bjornvaktaren/ccd-kaf-cdip24/software/indigo/README.md

INDIGO driver
=============

Download the INDIGO drivers source. Copy ccd_mik to indigo_drivers in the INDIGO source code. Make the indigo drivers.
