bjornvaktaren/ccd-kaf-cdip24/ecad/kaf_board/power_requirements.ods

 | max current (mA) |  |  |  |  |  |  |  | max power (mW)
 | 3.3VD | 1.2V | 5V | 5V ADC | 12V | +15V | -15V |  | 3.3VD | 1.2V | 5V | 5V ADC | 12V | +15V | -15V
component | 3.3 | 1.2 | 5 | 5 | 12 | 15 | 15 |  | 3.3 | 1.2 | 5 | 5 | 12 | 15 | 15
FT2232H | 150 |  | 0 |  |  |  |  |  | 495 | 0 | 0 | 0 | 0 | 0 | 0
93LC56BT | 2 |  | 0 |  |  |  |  |  | 6.6 | 0 | 0 | 0 | 0 | 0 | 0
iCE40HX4K | 30.8 | 29.367 | 0 |  |  |  |  |  | 101.64 | 35.2404 | 0 | 0 | 0 | 0 | 0
MCP3004 | 1 |  | 0 |  |  |  |  |  | 3.3 | 0 | 0 | 0 | 0 | 0 | 0
AD9826 | 5 |  | 0 | 75 |  |  |  |  | 16.5 | 0 | 0 | 375 | 0 | 0 | 0
KAF-3200 |  |  | 0 |  |  | 10 | 10 |  | 0 | 0 | 0 | 0 | 0 | 150 | 150
MAX4649 |  |  | 0 |  |  | 0.1 | 0.1 |  | 0 | 0 | 0 | 0 | 0 | 1.5 | 1.5
TC4427 V1/V2 |  |  | 0 |  |  | 4.5 | 4.5 |  | 0 | 0 | 0 | 0 | 0 | 67.5 | 67.5
TC4427 R |  |  | 0 |  |  | 4.5 | 4.5 |  | 0 | 0 | 0 | 0 | 0 | 67.5 | 67.5
TC4428 H1/H2 |  |  | 0 |  |  | 4.5 | 4.5 |  | 0 | 0 | 0 | 0 | 0 | 67.5 | 67.5
LM224 1 |  |  | 0 |  |  | 6 | 6 |  | 0 | 0 | 0 | 0 | 0 | 90 | 90
LM224 2 |  |  | 0 |  |  | 6 | 6 |  | 0 | 0 | 0 | 0 | 0 | 90 | 90
LM224 3 |  |  | 0 |  |  | 6 | 6 |  | 0 | 0 | 0 | 0 | 0 | 90 | 90
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
