bjornvaktaren/ccd-kaf-cdip24/spice/bias_tee.asc

C1: cap; 33µ; V=10 Irms=15.2 Rser=0.00332739 Lser=0
L1: ind; 1000n; Ipk=0.4 Rser=0.648 Rpar=94.2 Cpar=0
R1: res; 1000k
R2: res; 1k
V1: voltage; -8.5
V2: voltage; PULSE(0 3.3 0 5n 5n 50n 100n 3200000)
Named nets: 0
.tran 1000ms
