bjornvaktaren/ccd-kaf-cdip24/ecad/kaf_board/kaf_board.kicad_pcb

## KiCad design ecad/kaf_board/kaf_board.kicad_pcb (2020-12-25)

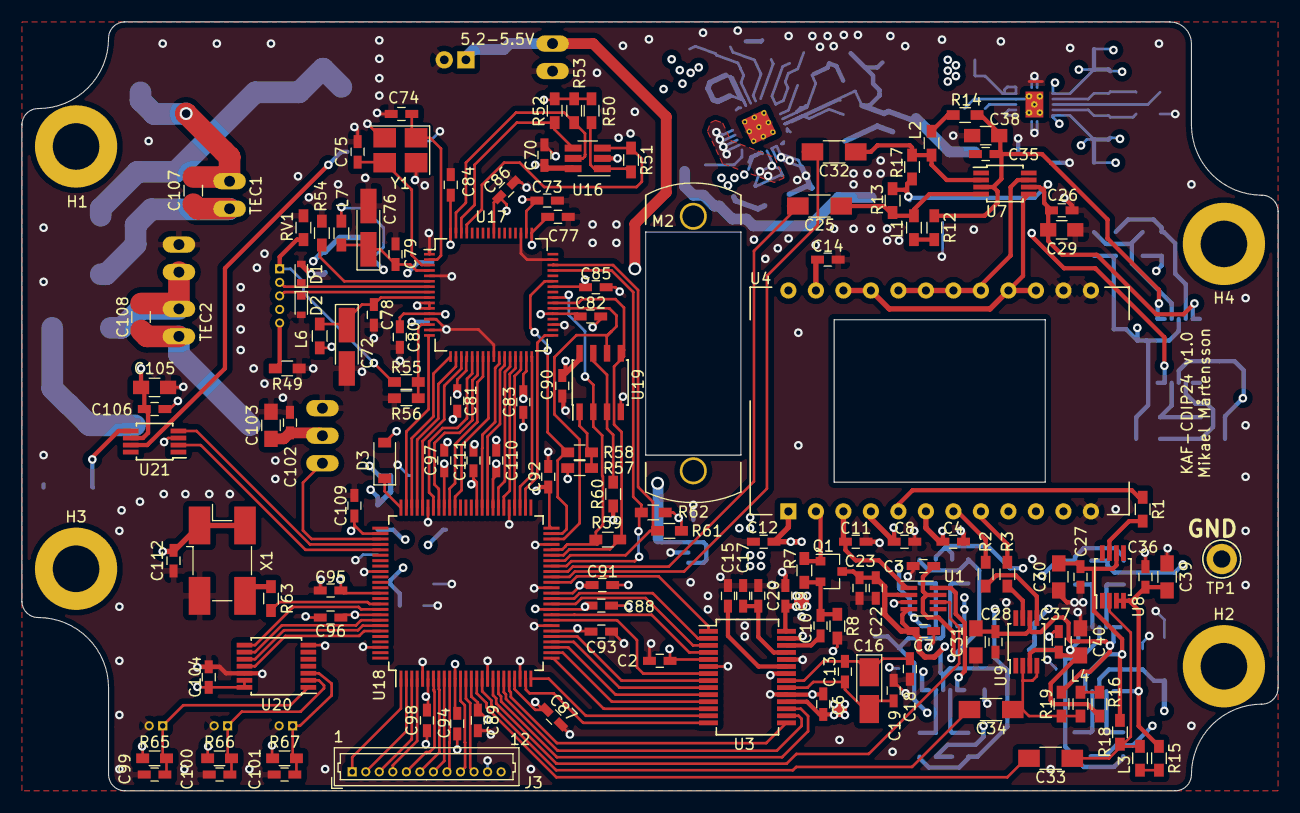
[picture p1: board kaf_board.kicad_pcb from above]

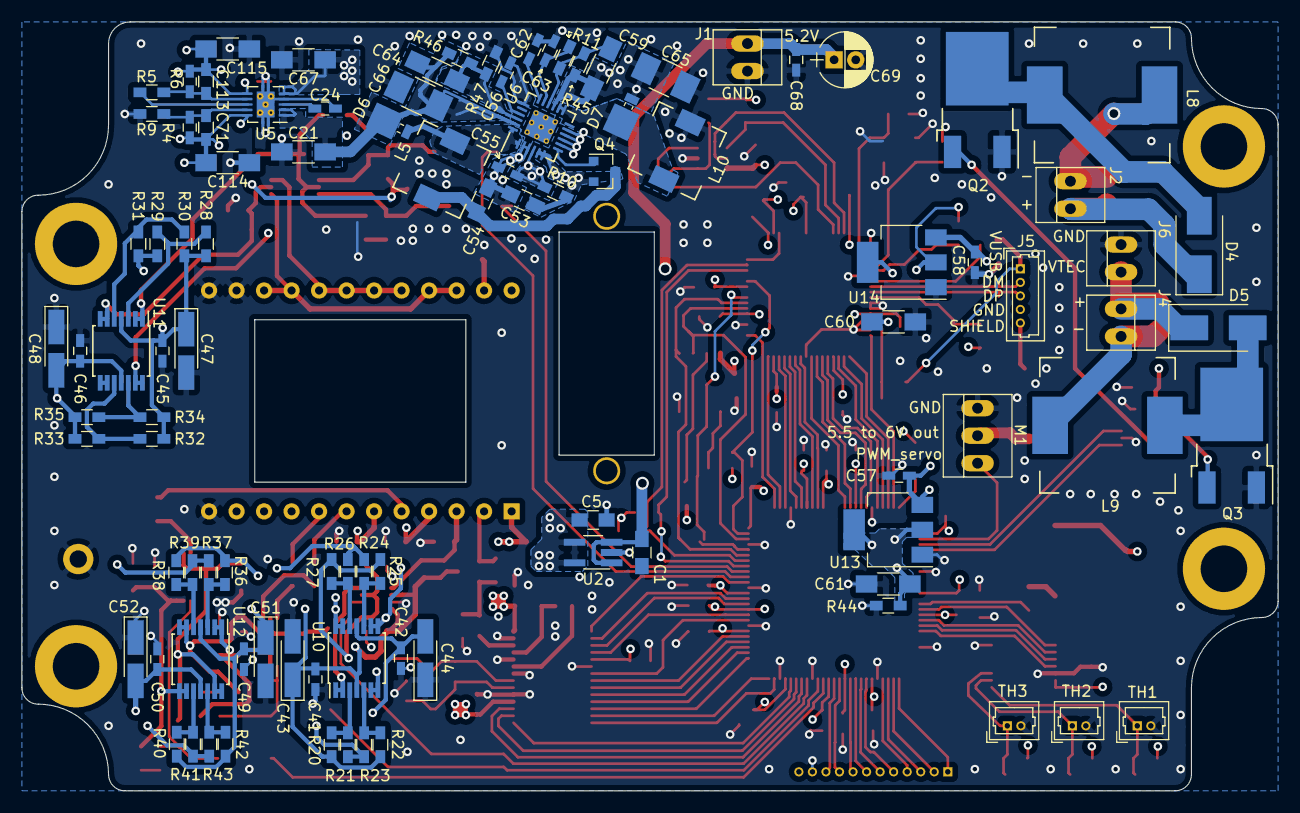
[picture p2: board kaf_board.kicad_pcb from below]

Board: 4 copper layers, 116.0 x 71.0 mm, 240 parts (99 on the bottom side), 159 nets.

Parts:
C1, C5: 2.2u X7R; C_0805_HandSoldering
C2, C3, C6, C7, C9, C10, C13, C15, C17, C18, C19, C23, C24, C26, C27, C28, C35, C36, C37, C41, C42, C45, C46, C49, C50, C55, C57, C58, C68, C70, C73, C78, C79, C80, C81, C82, C83, C84, C85, C86, C87, C88, C89, C90, C91, C92, C93, C94, C95, C96, C97, C98, C99, C100, C101, C102, C106, C109, C110, C111, C112: 0.1u; C_0603_HandSoldering
C4, C8, C11, C12, C14: 0; C_0603_HandSoldering
C16: 10u; CP_Tantalum_Case-R_EIA-2012-12_Hand
C20, C22, C104: 1u; C_0603_HandSoldering
C21, C60, C61, C67, C114, C115: 10u; C_1206_HandSoldering
C25, C32, C33, C34: 33u; C_1206_HandSoldering
C29, C30, C31, C38, C39, C40, C53, C54, C103, C105, C107, C108: 4.7u; C_0805_HandSoldering
C43, C44, C47, C48, C51, C52: 4.7u; CP_Tantalum_Case-A_EIA-3216-18_Hand
C56, C71, C113: 10n; C_0603_HandSoldering
C59: populate? No. (5.6p); C_1206_HandSoldering
C62: 4.7n; C_0603_HandSoldering
C63: 220n; C_0603_HandSoldering
C64: 6.8p; C_1206_HandSoldering
C65, C66: 22u; C_1210_HandSoldering
C69: 47u; CP_Radial_D5.0mm_P2.00mm
C72, C76: 4.7u tan; CP_Tantalum_Case-A_EIA-3216-18_Hand
C74, C75: 27p; C_0603_HandSoldering
C77: 3.3u; C_0603_HandSoldering
D1, D2: PGB101; D_0603
D3: 1N5819; D_SOD-123
D4, D5: VS-4EGU06-M3; D_SMB_Handsoldering
D6, D7: MBRM120; D_Powermite_AK
H1, H2, H3, H4: MountingHole; MountingHole_4.3mm_M4_ISO7380_Pad
J1: PWR; PINHEAD1-2
J2: TEC1; PINHEAD1-2
J3: Conn_01x12; Molex_PicoBlade_53047-1210_12x1.25mm_Straight
J4: TEC2; PINHEAD1-2
J5: USB; Molex_PicoBlade_53047-0510_05x1.25mm_Straight
J6: TECPWR; PINHEAD1-2
L1, L2, L3, L4: 1u; L_0603_HandSoldering
L5, L10: 4.7u; L_SMT_B82462G4
L6, L7: 600R/0.5A; L_0603_HandSoldering
L8, L9: 100u; L_Bourns_1210
M1: Motor_Servo; PINHEAD1-3
M2: Servo cut-out; HD-1440A
Q1: MMBT3904LT1G; SOT-23
Q2, Q3: NTD4804N; ONSemi_DPAK-3_5.97x6.35mm
Q4: Si2323DS; SOT-23
R1, R2, R3: 68; R_0603_HandSoldering
R4: 169k 0.1%; R_0603_HandSoldering
R5: 12k 0.1%; R_0603_HandSoldering
R6: 147k 0.1%; R_0603_HandSoldering
R7: 140; R_0603_HandSoldering
R8, R12, R14, R15, R16: 1k; R_0603_HandSoldering
R9: 15k 0.1%; R_0603_HandSoldering
R10: 100; R_0603_HandSoldering
R11: 104.8k; R_0603_HandSoldering
R13, R17, R18, R19, R49: NA; R_0603_HandSoldering
R20, R21, R22, R23, R24, R25, R26, R27, R28, R29, R30, R31, R32, R33, R34, R35, R36, R37, R38, R39, R40, R41, R42, R43: R; R_0603_HandSoldering
R44: 120; R_0603_HandSoldering
R45: 1.3M; R_0603_HandSoldering
R46: 975k; R_0603_HandSoldering
R47: 85.8k; R_0603_HandSoldering
R50, R52, R53, R56, R57, R60, R61, R65, R66, R67: 10k; R_0603_HandSoldering
R51: 2k; R_0603_HandSoldering
R54: 12k 1%; R_0603_HandSoldering
R55: 4.7k; R_0603_HandSoldering
R58, R63: 22; R_0603_HandSoldering
R59: NA(22); R_0603_HandSoldering
R62: 2.2k; R_0603_HandSoldering
RV1: V5.5MLA; R_0603_HandSoldering
TH1, TH2, TH3: 2000, beta 3500; Molex_PicoBlade_53047-0210_02x1.25mm_Straight
TP1: GND; Test_Point_Keystone_5005-5009_Compact
U1: MAX4649; SOT-23-8_Handsoldering
U2: ADP7118AUJZ; TSOT-23-5_HandSoldering
U3: AD9826; SSOP-28_5.3x10.2mm_Pitch0.65mm
U4: KAF-CDIP24; CDIP-24_20.2x34.5mm_P2.54mm
U5: TPS7A39; TI_WSON-10-1TP_3x3mm_P0.5mm_HandSolder
U6: TPS6513x; TI_WQFN-24-1EP_4x4mm_P0.5mm_HandSolder
U7, U8, U21: TC4427; MSOP-8_3x3mm_Pitch0.65mm
U9: TC4428; MSOP-8_3x3mm_Pitch0.65mm
U10, U11, U12: LM224; TSSOP-14_4.4x5mm_Pitch0.65mm
U13: LD1117S12CTR_SOT223; SOT-223-3_TabPin2
U14: LD1117S33CTR_SOT223; SOT-223-3_TabPin2
U16: 93LCxxBxxOT; SOT-23-6_Handsoldering
U17: FT2232HL; LQFP-64_10x10mm_Pitch0.5mm
U18: ICE40HX1K-VQ100; LQFP-100_14x14mm_Pitch0.5mm
U19: W25X20CL; SOIC-8_3.9x4.9mm_Pitch1.27mm
U20: MCP3004; TSSOP-14_4.4x5mm_Pitch0.65mm
X1: KC7050A-C3; Oscillator_SMD_EuroQuartz_XO91-4pin_7.0x5.0mm_HandSoldering
Y1: 12 MHz; Crystal_SMD_3225-4pin_3.2x2.5mm_HandSoldering

Connections:
+1V2: C61.1, C88.1, C94.1, C109.1, C111.1, R44.2, U13.2, U18.11, U18.35, U18.61, U18.77
+3V3: C2.2, C60.1, C70.1, C73.1, C81.1, C83.1, C85.1, C86.1, C87.1, C89.1, C90.1, C91.1, C92.1, C93.1, C95.1, C96.1, C97.1, C98.1, C104.1, C110.1, C112.1, D3.2, J3.12, L6.2, L7.2, R50.1, R52.1, R53.1, R57.2, R60.1, R61.1, R62.1, R65.1, R66.1, R67.1, U3.5, U14.2, U16.6, U17.20, U17.31, U17.42, U17.50, U17.56, U18.6, U18.14, U18.22, U18.31, U18.38, U18.50, U18.58, U18.67, U18.88, U18.92, U19.8, U20.13, U20.14, X1.1, X1.4
+6V: C1.2, C53.1, C57.1, C58.1, C68.1, C69.1, C102.1, C103.1, J1.1, M1.2, Q4.2, R10.2, U2.1, U2.3, U6.5, U6.6, U13.3, U14.3
+14.5V: C7.2, C22.2, C23.2, C41.2, C43.1, C45.2, C47.1, C49.2, C51.1, C71.2, C114.2, Q1.3, R4.1, R20.1, R22.1, R24.1, R26.1, R28.1, R30.1, R32.1, R34.1, R36.1, R38.1, R40.1, R42.1, U1.2, U1.4, U5.10, U10.4, U11.4, U12.4
-14.5V: C3.2, C42.2, C44.2, C46.2, C48.2, C50.2, C52.2, C113.1, C115.2, R6.2, R21.2, R23.2, R25.2, R27.2, R29.2, R31.2, R33.2, R35.2, R37.2, R39.2, R41.2, R43.2, U1.7, U5.6, U10.11, U11.11, U12.11
/ccd/AD_ADCLK: U3.3, U18.36
/ccd/AD_CDSCLK1: U3.1, U18.40
/ccd/AD_CDSCLK2: U3.2, U18.37
/ccd/AD_D0: U3.14, U18.24
/ccd/AD_D1: U3.13, U18.25
/ccd/AD_D2: U3.12, U18.26
/ccd/AD_D3: U3.11, U18.27
/ccd/AD_D4: U3.10, U18.28
/ccd/AD_D5: U3.9, U18.29
/ccd/AD_D6: U3.8, U18.30
/ccd/AD_D7: U3.7, U18.33
/ccd/AD_OEB: U3.4, U18.34
/ccd/AD_SCLK: U3.16, U18.20
/ccd/AD_SDATA: U3.15, U18.21
/ccd/AD_SLOAD: U3.17, U18.19
/ccd/AMP_OFF: U1.6, U18.18
/ccd/AVDD: C5.2, C6.2, C9.2, U2.4, U2.5, U3.18, U3.28
/ccd/H1: R2.2, U9.5
/ccd/H2: R3.2, U9.7
/ccd/H_3.3V: C34.2, U18.16
/ccd/R: R1.2, U8.7
/ccd/R_3.3V: C33.2, U18.15
/ccd/V1: U4.15, U4.16, U4.21, U4.22, U7.5
/ccd/V1_3.3V: C25.2, U18.42
/ccd/V2: U4.17, U4.18, U4.19, U4.20, U7.7
/ccd/VGUARD: C14.1, U4.23, U11.13, U11.14
/ccd/VOG: C12.1, U4.1, U10.6, U10.7
/ccd/VOUT_BUF: C10.1, Q1.2, R7.1, R8.1
/ccd/VRD: C8.1, U4.4, U10.8, U10.9
/ccd/VSS: C4.1, U4.6, U10.13, U10.14
/ccd/V_AMP: C11.1, U1.1, U4.3
/ccd/V_AMPL: U1.8, U10.1, U10.2
/ccd/V_HH: C28.2, C31.2, R19.1, U9.6, U12.6, U12.7
/ccd/V_HL: C37.2, C40.2, R16.1, U9.3, U12.1, U12.2
/ccd/V_RH: C27.2, C30.2, R18.1, U8.6, U12.13, U12.14
/ccd/V_RL: C36.2, C39.2, R15.1, U8.3, U8.4, U12.8, U12.9
/ccd/V_VH: C26.2, C29.2, R13.1, R17.1, U7.6, U11.6, U11.7
/ccd/V_VL: C35.2, C38.2, R12.1, R14.1, U7.3, U11.1, U11.2
/ccd/ccd_voltage_2/V3: U11.8, U11.9
/fpga/AUX1: J3.1, U18.1
/fpga/AUX2: J3.2, U18.2
/fpga/AUX3: J3.3, U18.3
/fpga/AUX4: J3.4, U18.4
/fpga/AUX5: J3.5, U18.7
/fpga/AUX6: J3.6, U18.8
/fpga/AUX7: J3.7, U18.9
/fpga/AUX8: J3.8, U18.10
/fpga/AUX9: J3.9, U18.12
/fpga/AUX10: J3.10, U18.13
/fpga/CLK: R63.1, U18.90
/fpga/FT_CLKOUT: U17.32, U18.53
/fpga/FT_D0: U17.16, U18.74
/fpga/FT_D1: U17.17, U18.73
/fpga/FT_D2: U17.18, U18.72
/fpga/FT_D3: U17.19, U18.71
/fpga/FT_D4: U17.21, U18.69
/fpga/FT_D5: U17.22, U18.68
/fpga/FT_D6: U17.23, U18.66
/fpga/FT_D7: U17.24, U18.65
/fpga/FT_OE#: U17.33, U18.52
/fpga/FT_RD#: U17.28, U18.57
/fpga/FT_RXF#: U17.26, U18.60
/fpga/FT_SIWUA: U17.30, U18.54
/fpga/FT_TXE#: U17.27, U18.59
/fpga/FT_WR#: U17.29, U18.56
/fpga/MCP_CLK: U18.95, U20.11
/fpga/MCP_CS_N: U18.91, U20.8
/fpga/MCP_DIN: U18.93, U20.9
/fpga/MCP_DOUT: U18.94, U20.10
/fpga/PWM_SERVO: M1.1, U18.78
/fpga/PWM_TEC1: U18.80, U21.2
/fpga/PWM_TEC2: U18.79, U21.4
/fpga/V1_3.3V: C32.2, U18.41
/fpga/VPP_2V5: D3.1, U18.75
/power/+15V: C21.2, C64.1, C66.1, D6.1, R46.2, U5.1, U5.2, U6.23
/power/-15V: C59.2, C65.1, C67.2, D7.2, R45.1, U5.5, U6.15
/thermo_and_mechanical/V_TEC: C105.1, C106.1, C107.1, C108.1, D4.1, D5.1, J2.1, J4.1, J6.1, U21.6
/usb-interface/DM: D1.1, J5.2, U17.7
/usb-interface/DP: D2.1, J5.3, U17.8
/usb-interface/FT_CDONE: R62.2, U17.45, U18.43
/usb-interface/FT_CRESET: R61.2, U17.46, U18.44
/usb-interface/FT_MISO: R59.1, U17.40, U18.46, U19.2
/usb-interface/FT_MOSI: R59.2, U17.39, U18.45, U19.5
/usb-interface/FT_SCK: U17.38, U18.48, U19.6
/usb-interface/FT_SS: R58.1, U17.43, U18.49
/usb-interface/VPHY: C76.1, C79.1, L7.1, U17.4
/usb-interface/VREG: C77.1, C80.1, C82.1, C84.1, U17.12, U17.37, U17.49, U17.64
/usb-interface/VUSB: J5.1, R55.2, RV1.2
GND: C1.1, C2.1, C3.1, C4.2, C5.1, C6.1, C7.1, C8.2, C9.1, C11.2, C12.2, C14.2, C15.2, C17.1, C18.2, C19.2, C20.1, C21.1, C22.1, C23.1, C24.1, C26.1, C27.1, C28.1, C29.1, C30.1, C31.1, C35.1, C36.1, C37.1, C38.1, C39.1, C40.1, C41.1, C42.1, C43.2, C44.1, C45.1, C46.1, C47.2, C48.1, C49.1, C50.1, C51.2, C52.1, C53.2, C54.2, C55.2, C56.2, C57.2, C58.2, C60.2, C61.2, C62.2, C63.2, C65.2, C66.2, C67.1, C68.2, C69.2, C70.2, C72.2, C73.2, C74.2, C75.1, C76.2, C77.2, C78.2, C79.2, C80.2, C81.2, C82.2, C83.2, C84.2, C85.2, C86.2, C87.2, C88.2, C89.2, C90.2, C91.2, C92.2, C93.2, C94.2, C95.2, C96.2, C97.2, C98.2, C99.2, C100.2, C101.2, C102.2, C103.2, C104.2, C105.2, C106.2, C109.2, C110.2, C111.2, C112.2, C114.1, C115.1, D1.2, D2.2, J1.2, J3.11, J5.4, J6.2, L10.1, M1.3, Q2.3, Q3.3, R8.2, R9.2, R44.1, R47.1, R49.1, R54.1, R56.2, RV1.1, TH1.2, TH2.2, TH3.2, TP1.1, U1.3, U2.2, U3.6, U3.19, U3.22, U3.24, U3.27, U4.12, U4.13, U4.14, U5.4, U5.11, U6.2, U6.3, U6.19, U6.25, U13.1, U14.1, U16.2, U17.1, U17.5, U17.10, U17.11, U17.13, U17.15, U17.25, U17.35, U17.47, U17.51, U18.5, U18.17, U18.23, U18.32, U18.39, U18.47, U18.55, U18.70, U18.84, U18.98, U19.4, U20.7, U20.12, U21.3, X1.2, Y1.2, Y1.4
GNDPWR: J5.5, R49.2
unnamed: C10.2, U3.26
unnamed: C13.1, C16.2, C19.1, U3.20
unnamed: C13.2, C16.1, C18.1, U3.21
unnamed: C15.1, U3.23
unnamed: C17.2, C20.2, U3.25
unnamed: C24.2, U5.3
unnamed: C25.1, L1.2, R13.2, U7.4
unnamed: C32.1, L2.2, R17.2, U7.2
unnamed: C33.1, L3.2, R18.2, U8.2
unnamed: C34.1, L4.2, R19.2, U9.2, U9.4
unnamed: C54.1, L5.2, Q4.3
unnamed: C55.1, R10.1, U6.4, U6.8, U6.9, U6.10, U6.11
unnamed: C56.1, U6.21
unnamed: C59.1, R11.1, R45.2, U6.16
unnamed: C62.1, U6.18
unnamed: C63.1, R11.2, U6.17
unnamed: C64.2, R46.1, R47.2, U6.22
unnamed: C71.1, R4.2, R9.1, U5.9
unnamed: C72.1, C78.1, L6.1, U17.9
unnamed: C74.1, U17.2, Y1.1
unnamed: C75.2, U17.3, Y1.3
unnamed: C99.1, R65.2, TH1.1, U20.1
unnamed: C100.1, R66.2, TH2.1, U20.2
unnamed: C101.1, R67.2, TH3.1, U20.3
unnamed: C107.2, J2.2, L8.1
unnamed: C108.2, J4.2, L9.1
unnamed: C113.2, R5.2, R6.1, U5.7
unnamed: D4.2, L8.2, Q2.2, Q2.4
unnamed: D5.2, L9.2, Q3.2, Q3.4
unnamed: D6.2, L5.1, U6.1, U6.24
unnamed: D7.1, L10.2, U6.13, U6.14
unnamed: L1.1, R12.2
unnamed: L2.1, R14.2
unnamed: L3.1, R15.2
unnamed: L4.1, R16.2
unnamed: Q1.1, R7.2, U4.2
unnamed: Q2.1, U21.7
unnamed: Q3.1, U21.5
unnamed: Q4.1, U6.7
unnamed: R1.1, U4.5
unnamed: R2.1, U4.7
unnamed: R3.1, U4.8
unnamed: R5.1, U5.8
unnamed: R20.2, R21.1, U10.3
unnamed: R22.2, R23.1, U10.5
unnamed: R24.2, R25.1, U10.10
unnamed: R26.2, R27.1, U10.12
unnamed: R28.2, R29.1, U11.3
unnamed: R30.2, R31.1, U11.5
unnamed: R32.2, R33.1, U11.10
unnamed: R34.2, R35.1, U11.12
unnamed: R36.2, R37.1, U12.3
unnamed: R38.2, R39.1, U12.5
unnamed: R40.2, R41.1, U12.10
unnamed: R42.2, R43.1, U12.12
unnamed: R50.2, R51.2, U16.1
unnamed: R51.1, U16.3, U17.61
unnamed: R52.2, U16.4, U17.62
unnamed: R53.2, U16.5, U17.63
unnamed: R54.2, U17.6
unnamed: R55.1, R56.1, U17.14
unnamed: R57.1, R58.2, U19.1
unnamed: R60.2, U19.3, U19.7
unnamed: R63.2, X1.3
