bjornvaktaren/ccd-kaf-cdip24/firmware/controller.v

`default_nettype none

// `include "ram.v"
// `include "spi_slave.v"
`include "mcp3008_interface.v"
`include "sync_ft245.v"
`include "ccd_readout.v"
`include "fifo.v"

module controller
  (clk,         // clock
   ft_bus,      // ft232h data bus
   ft_rxf_n,    // ft232h read fifo (active low)
   ft_txe_n,    // ft232h transmit enable (active low)
   ft_rd_n,     // ft232h read data (active low)
   ft_wr_n,     // ft232h write (active low)
   ft_siwu_n,   // ft232h send immediate / wake up (active low)
   ft_clkout,   // ft232h clock
   ft_oe_n,     // ft232h output enable (active low)
   mcp_dclk,    // mcp3008 data clock
   mcp_dout,    // mcp3008 data out
   mcp_din,     // mcp3008 data in
   mcp_cs_n,    // mcp3008 active low chip select
   ad_cdsclk1,  // AD9826 correlated double-sampling clock 1
   ad_cdsclk2,  // AD9826 correlated double-sampling clock 1
   ad_adclk,    // AD9826 data clock
   ad_oeb_n,    // AD9826 output enable (active low)
   kaf_r,       // CCD reset clock
   kaf_h1,      // CCD H1 clock
   kaf_h2,      // CCD H2 clock
   kaf_v1,      // CCD V1 clock
   kaf_v2,      // CCD V2 clock
   kaf_amp,     // CCD amplifier on/off
   ad_data,     // Data output form the AD9826
   pwm_shutter, // PWM output for controlling the shutter servo
   pwm_peltier  // PWM output for controlling the peltier cooling
   );
   
   input        clk;
   inout [7:0]  ft_bus;
   input 	ft_rxf_n;
   input 	ft_txe_n;
   input        ft_clkout;
   output wire  ft_rd_n;
   output wire  ft_wr_n;
   output wire  ft_siwu_n;
   output wire 	ft_oe_n;
   input 	mcp_dout;
   output wire 	mcp_dclk;
   output wire  mcp_din;
   output wire 	mcp_cs_n;
   output wire  ad_cdsclk1;
   output wire 	ad_cdsclk2;
   output wire 	ad_adclk;
   output wire 	ad_oeb_n;
   output wire  kaf_r;
   output wire 	kaf_h1;
   output wire 	kaf_h2;
   output wire 	kaf_v1;
   output wire 	kaf_v2;
   output wire 	kaf_amp;
   input [7:0]  ad_data;
   output wire 	pwm_shutter;
   output wire 	pwm_peltier;

   // Gray coded states
   // 
   localparam state_idle             = 4'b0000; 
   // get command from FT245 interface
   localparam state_get_cmd          = 4'b0001;
   // evaluate the recieved command
   localparam state_eval_cmd         = 4'b0011;
   // send msb of ft_output_reg
   localparam state_ft_send_msb      = 4'b0010;
   // wait for handshake
   localparam state_ft_send_msb_wait = 4'b0110;
   // send lsb of ft_output_reg
   localparam state_ft_send_lsb      = 4'b0111;
   // wait for handshake
   localparam state_ft_send_lsb_wait = 4'b0101;
   // move mcp3008 output to ft_output_reg
   localparam state_move_mcp         = 4'b0100;
   // read out the ccd
   localparam state_toggle_ccd       = 4'b1100;
   // read out the ccd
   localparam state_ccd_wait_busy    = 4'b1101;

   // Shutter states
   localparam shutter_state_open   = 1'b0; // open shutter
   localparam shutter_state_closed = 1'b1; // close shutter

   // include header file with localparams needed across modules or for sim
   `include "controller.vh"

   // Clock divider
   
   reg [15:0] 	clk_div = 0;

   always @(posedge clk) begin
      clk_div <= clk_div + 1;
   end

      
   // Synchronous FT245 Interface
   
   reg        data_to_ft_avail;
   reg  [7:0] data_to_ft;
   wire       data_from_ft_avail;
   wire [7:0] data_from_ft;

   sync_ft245 sync_ft245 
     (
      .ft_bus(ft_bus),
      .ft_rxf_n(ft_rxf_n),
      .ft_txe_n(ft_txe_n),
      .ft_rd_n(ft_rd_n),
      .ft_wr_n(ft_wr_n),
      .ft_siwu_n(ft_siwu_n),
      .ft_clkout(ft_clkout),
      .ft_oe_n(ft_oe_n),
      .data_to_ft(data_to_ft),
      .data_to_ft_avail(data_to_ft_avail),
      .data_from_ft(data_from_ft),
      .data_from_ft_avail(data_from_ft_avail)
      );


   // MCP3008 ADC interface

   reg 	      mcp_sample = 0;
   wire       mcp_busy;
   wire [9:0] mcp_data;
   wire       mcp_dclk_internal;
`ifdef SYNTHESIS
   // 100 MHz / 2^(6+1) = 0.78 MHz
   assign mcp_dclk_internal = clk_div[6];
`else
   // Makes is easier to see in simulation
   assign mcp_dclk_internal = clk_div[6];
`endif
   // Only output the clock if needed
   assign mcp_dclk = (mcp_cs_n == 1'b0) ? mcp_dclk_internal : 1'b1;

   mcp3008_interface mcp3008
     (
      mcp_sample,
      mcp_dclk_internal, // mcp3008 data clock, internal to the FPGA
      mcp_dout,          // mcp3008 data out
      mcp_din,           // mcp3008 data in
      mcp_cs_n,          // mcp3008 active low chip select
      mcp_busy,
      mcp_data
      );


   // Readout module for the CCD and CCD signal processor
   
   `include "ccd_readout.vh"

   wire      ccd_busy;
   reg       ccd_toggle;
   reg [1:0] ccd_mode = ccd_mode_readout_1x1;
   
   ccd_readout ccd
     (
      .ad_cdsclk1(ad_cdsclk1),
      .ad_cdsclk2(ad_cdsclk2),
      .ad_adclk(ad_adclk),
      .ad_oeb_n(ad_oeb_n),
      .kaf_r(kaf_r),
      .kaf_h1(kaf_h1),
      .kaf_h2(kaf_h2),
      .kaf_v1(kaf_v1),
      .kaf_v2(kaf_v2),
      .kaf_amp(kaf_amp),
      .counter(clk_div),
      .busy(ccd_busy),
      .toggle(ccd_toggle),
      .mode(ccd_mode)
      );


   // FIFO for ccd readout
   wire      fifo_write_clk = clk_div[ccd_counter_clk_bit];

   fifo #(8, 8) fifo
     (
      .rdata(),
      .wfull(),
      .rempty(),
      .wdata(ad_data),
      .winc(),
      .wclk(fifo_write_clk),
      .wrst_n(),
      .rinc(),
      .rclk(ft_clkout),
      .rrst_n()
      );
   

   // Shutter PWM
   
   reg [7:0] pwm_shutter_duty_cycle = shutter_closed_duty_cycle;
   localparam shutter_closed_duty_cycle = 8'h10;
   localparam shutter_open_duty_cycle = 8'h20;
  
   assign pwm_shutter = clk_div[7:0] <= pwm_shutter_duty_cycle ? 1 : 0;


   // State-machine
   
   reg [3:0]   state = state_idle;
   reg 	       shutter_state = shutter_state_closed;
   reg [15:0]  ft_output_reg;
   reg [7:0]   command;
   
   // state logic
   always @(posedge clk) begin

      case (state)
	
   	state_idle:
	  // wait for ft245 interface to tell the fpga what to do
	  if (ft_rxf_n == 1'b0) 
	    state <= state_get_cmd;
	
	state_get_cmd:
	  // wait for the sync_ft245 module to have recieved data
	  if (data_from_ft_avail == 1'b1)
	    state <= state_eval_cmd;

	state_eval_cmd: begin
	   // Take different actions. Go back to idle if the command is invalid
	   state <= state_idle;
	   if (data_from_ft == cmd_get_mcp)
	     state <= state_move_mcp;
	   if (data_from_ft == cmd_read_ccd)
	     state <= state_toggle_ccd;
	   if (data_from_ft == cmd_shutter_close)
	     shutter_state <= shutter_state_closed;
	   if (data_from_ft == cmd_shutter_open)
	     shutter_state <= shutter_state_open;
	end

	// state_sample_mcp:
	//   if (mcp_busy == 1'b1)
	//     state <= state_mcp_wait;
	
	// state_mcp_wait:
	//   if (mcp_busy == 1'b0)
	//     state <= state_mcp_to_ft_bus;
	
	state_toggle_ccd:
	  if (ccd_busy == 1'b0)
	    state <= state_ccd_wait_busy;
	
	state_ccd_wait_busy:
	  // while there is data in the fifo
	  if (ccd_busy == 1'b1)
	    state <= state_ft_send_lsb;

	state_move_mcp:
	  if (ft_txe_n == 1'b0)
	    state <= state_ft_send_msb;

	state_ft_send_msb:
	  if (ft_wr_n == 1'b0)
	    state <= state_ft_send_msb_wait;
	
	state_ft_send_msb_wait:
	  if (ft_wr_n == 1'b1)
	    state <= state_ft_send_lsb;

	state_ft_send_lsb:
	  if (ft_wr_n == 1'b0)
	    state <= state_ft_send_lsb_wait;
	
	state_ft_send_lsb_wait:
	  // should go back to state_ccd_to_ft_bus if streaming
	  if (ft_wr_n == 1'b1)
	    state <= state_idle; 

	// state_shutter_open:
	//     state <= state_idle; 

	// state_shutter_close:
	//     state <= state_idle; 
	
   	default: state <= state_idle;
	
      endcase // case (state)
      
   end // always @ (posedge clk)
   

   // state task logic
   always @* begin

      data_to_ft_avail   = 1'b0;
      data_to_ft         = 8'b0;
      ccd_toggle         = 0;
      ft_output_reg      = 16'b0;
	
      if(state == state_idle) begin
      end
      if(state == state_get_cmd) begin
      end
      if(state == state_eval_cmd) begin
      end
      if(state == state_ft_send_msb) begin
	 data_to_ft       = ft_output_reg[15:8];
	 data_to_ft_avail = 1'b1;
      end
      if(state == state_ft_send_msb_wait) begin
	 data_to_ft       = ft_output_reg[15:8];
	 data_to_ft_avail = 1'b0;
      end
      if(state == state_ft_send_lsb) begin
	 data_to_ft       = ft_output_reg[7:0];
	 data_to_ft_avail = 1'b1;
      end
      if(state == state_ft_send_lsb_wait) begin
	 data_to_ft       = ft_output_reg[7:0];
	 data_to_ft_avail = 1'b0;
      end
      if(state == state_toggle_ccd) begin
	 ccd_toggle = 1'b1;
      end
      if(state == state_ccd_wait_busy) begin
	 ccd_toggle = 1'b1;
      end
      if(state == state_move_mcp) begin
	 ft_output_reg[9:0]   = mcp_data;
	 ft_output_reg[15:10] = 6'b0;
      end
      
      // shutter states
      if(shutter_state == shutter_state_open) begin
	 pwm_shutter_duty_cycle = shutter_open_duty_cycle;
      end
      if(shutter_state == shutter_state_closed) begin
	 pwm_shutter_duty_cycle = shutter_closed_duty_cycle;
      end
   end // always @*


   // continuously sample the temperture sensors connected to the mcp
   wire mcp_sample_clk = clk_div[11]; // should be every second or so.
   
   always @(posedge mcp_sample_clk) begin
      // If the ADC is done converting, shift out the 16 bits
      mcp_sample <= ~mcp_sample;
   end


   
endmodule // controller
