bjornvaktaren/ccd-kaf-cdip24/firmware/testbench/ad9826_config_state_filter.txt

# ad9826_config module state filter for GTKWave
00000 idle
00001 rw
00011 a2
00010 a1
00110 a0
00111 dc1
00101 dc2
00100 dc3
01100 rd8
01101 rd7
01111 rd6
01110 rd5
01010 rd4
01011 rd3
01001 rd2
01000 rd1
11000 rd0
11001 wait_fifo
11011 wd8
11010 wd7
11110 wd6
11111 wd5
11101 wd4
11100 wd3
10100 wd2
10101 wd1
10111 wd0
