bjornvaktaren/ccd-kaf-cdip24/software/src/Camera.cpp

#include <Camera.hpp>

Camera::Camera(Ft245Interface& ft245)
    : m_verbosity{Verbosity::info},
      m_coolerOn{false},
      ft245_{ft245},
      m_ad{},
      m_thermistors{{fpga::thermistor_id::ambient,
                     Thermistor(2000.0, 3500.0, 3.3, 10000, 1023.0)},
                    {fpga::thermistor_id::ccd,
                     Thermistor(2000.0, 3500.0, 3.3, 10000, 1023.0)},
                    {fpga::thermistor_id::tec,
                     Thermistor(2000.0, 3500.0, 3.3, 10000, 1023.0)}},
      m_ccdTargetTemperature{20.0},
      m_pid{0.0, 255.0, -42.0, -0.3,
            0.0},  // PID regulator: min, max, kp, ki, kd
      m_pidOutPercent{-1.0},
      m_imageData{},
      m_rawPixelData{} {
   m_imageData.resize(this->getWidth() * this->getHeight(), 0);
   m_rawPixelData.resize(this->getWidth() * this->getHeight() * 3, 0);
}

void Camera::connect() {
   int status = ft245_.Open();
   if (status != 0) {
      throw std::runtime_error("Unable to connect to camera");
   }
   if (!ft245_.WriteByte(fpga::command::reset)) {
      throw std::runtime_error("Unable to reset camera");
   }

   // Configure the AD9826
   ft245_.Write({
       fpga::command::rw_adconf, fpga::ad9826::cmd::write_config,
       0b11011000  // 4 V input, internal Vref, 1 Ch mode, CDS, 4V clamp
   });
   // Read back the result, same number of bytes. Discard with the
   // result.
   auto data{ft245_.Read(3)};
   this->setGain(35);  // default gain
}

// void Camera::disconnect() { ft245_.close(); }

// bool Camera::setGain(const unsigned char gain) {
//    if (gain > 63) {
//       std::cout << "Gain can't be larger than 63. Ignoring.\n";
//       return false;
//    }

//    // Configure the AD9826
//    const size_t nBytes = 3;
//    const unsigned char writeBuffer[nBytes] = {
//        fpga::command::rw_adconf,
//        fpga::ad9826::cmd::write_gain,
//        gain,
//    };
//    bool ok = ft245_.write(writeBuffer, nBytes);
//    // Read back the result, same number of bytes. Discard with the result.
//    unsigned char buffer[nBytes] = {0};
//    int readBytes = ft245_.read(buffer, nBytes);

//    return ok;
// }

// bool Camera::setOffset(const unsigned char offset, const bool negative) {
//    // If negative, the LSB of the command is set to 1.
//    unsigned char write_cmd = fpga::ad9826::cmd::write_offset;
//    if (negative) write_cmd |= 0b00000001;
//    std::cout << std::bitset<8>(write_cmd) << ' ' << std::bitset<8>(offset)
//              << '\n';

//    // Configure the AD9826
//    const size_t nBytes = 3;
//    const unsigned char writeBuffer[nBytes] = {
//        fpga::command::rw_adconf,
//        write_cmd,
//        offset,
//    };
//    bool ok = ft245_.write(writeBuffer, nBytes);
//    // Read back the result, same number of bytes. Discard the result.
//    unsigned char buffer[nBytes] = {0};
//    int readBytes = ft245_.read(buffer, nBytes);

//    return ok;
// }

// void Camera::startExposure(const bool openShutter) {
//    std::cout << "Flushing\n";
//    this->flushSensor();
//    std::this_thread::sleep_for(std::chrono::seconds(2));
//    if (openShutter) {
//       std::cout << "Open shutter\n";
//       this->openShutter();
//    }
// }

// void Camera::stopExposure(const bool closeShutter) {
//    if (closeShutter) {
//       std::cout << "Close shutter\n";
//       this->closeShutter();
//    }
//    const size_t nBytesWrite = 4;
//    const unsigned char writeBuffer[nBytesWrite] = {
//        fpga::command::set_register, fpga::reg_addr::ccd_readout_mode,
//        fpga::ccd_readout_mode::bin1x1, fpga::command::toggle_read_ccd};
//    std::cout << "Initiating Readout\n";
//    bool ok = ft245_.write(writeBuffer, nBytesWrite);

//    // Get the image data
//    const size_t chunksize = 16384;  // Max buffer size in libftdi
//    size_t totalBytesRead = 0;
//    const size_t bytesToRead = this->getWidth() * this->getHeight() * 3;
//    int nTimesStuck = 0;
//    while (totalBytesRead < bytesToRead && nTimesStuck < 20) {
//       size_t bytesLeft = bytesToRead - totalBytesRead;
//       size_t chunk = bytesLeft < chunksize ? bytesLeft : chunksize;
//       // std::cout << "Trying to read " << chunk << " bytes\n";
//       unsigned char buffer[chunk] = {255};
//       size_t bytesRead = ft245_.read(buffer, chunk);
//       // Just dump it to a vector and process it later
//       for (size_t i = 0; i < bytesRead; ++i) {
//          m_rawPixelData[i + totalBytesRead] = buffer[i];
//       }
//       if (bytesRead <= 0)
//          ++nTimesStuck;
//       else
//          nTimesStuck = 0;
//       totalBytesRead += bytesRead > 0 ? bytesRead : 0;
//    }
//    // Decode raw data to
//    for (int i = 0; i < totalBytesRead / 3; ++i) {
//       auto packet =
//           this->decodePacket(m_rawPixelData[3 * i], m_rawPixelData[3 * i +
//           1],
//                              m_rawPixelData[3 * i + 2]);
//       if (packet.topic == fpga::DataTopic::pixel) {
//          m_imageData[i] = packet.data;
//       } else {
//          std::cout << "DEBUG: Expected pixel, but got someting else\n";
//       }
//    }
// }

// void Camera::flushSensor() {
//    // Configure
//    const size_t nBytes = 4;
//    const unsigned char writeBuffer[nBytes] = {
//        fpga::command::set_register, fpga::reg_addr::ccd_readout_mode,
//        fpga::ccd_readout_mode::flush, fpga::command::toggle_read_ccd};
//    bool ok = ft245_.write(writeBuffer, nBytes);
// }

// fpga::DataPacket Camera::decodePacket(const unsigned char byte1,
//                                       const unsigned char byte2,
//                                       const unsigned char byte3) {
//    if (m_verbosity == Verbosity::debug) {
//       std::cout << "DEBUG: "
//                 << " Got bytes " << std::bitset<8>(byte1) << '_'
//                 << std::bitset<8>(byte2) << '_' << std::bitset<8>(byte3);
//    }
//    fpga::DataPacket dataPacket;
//    if (byte1 == fpga::data_topic::mcp) {
//       dataPacket.topic = fpga::DataTopic::mcp;
//       if (m_verbosity == Verbosity::debug) {
//          std::cout << ": "
//                    << " topic 'mcp'";
//       }
//    } else if (byte1 == fpga::data_topic::adconf) {
//       dataPacket.topic = fpga::DataTopic::adconf;
//       if (m_verbosity == Verbosity::debug) {
//          std::cout << ": "
//                    << " topic 'adconf'";
//       }
//    } else if (byte1 == fpga::data_topic::pixel) {
//       dataPacket.topic = fpga::DataTopic::pixel;
//       if (m_verbosity == Verbosity::debug) {
//          std::cout << ": "
//                    << " topic 'pixel'";
//       }
//    } else {
//       std::cout << "Error: "
//                 << " Got unknown topic byte: " << std::bitset<8>(byte1) <<
//                 '\n';
//    }

//    dataPacket.data =
//        (static_cast<uint16_t>(byte2) << 8) | static_cast<uint16_t>(byte3);
//    if (m_verbosity == Verbosity::debug) {
//       std::cout << ", data " << std::bitset<16>(dataPacket.data) << '\n';
//    }
//    return dataPacket;
// }

// void Camera::decodeTemperatures(const fpga::DataPacket packet) {
//    try {
//       m_thermistors.at(packet.data & fpga::thermistor_id::bitmask)
//           .setMeasurement(packet.data & ~fpga::thermistor_id::bitmask);
//    } catch (const std::out_of_range& oor) {
//       std::cerr << "ERROR: Unable to decode thermistor ID. Exception: "
//                 << oor.what() << '\n';
//    }
// }

// void Camera::decodeAD9826ConfigPacket(const fpga::DataPacket packet) {
//    const uint16_t address = packet.data & fpga::ad9826::reg::addr_mask;
//    const uint16_t data = packet.data & fpga::ad9826::reg::data_mask;
//    const std::bitset<16> bits(data);

//    if (address == fpga::ad9826::reg::config) {
//       m_ad.inputRange = bits.test(7) ? "4V" : "2V";
//       m_ad.internalVRef = bits.test(6);
//       m_ad.threeChMode = bits.test(5);
//       m_ad.cdsMode = bits.test(4);
//       m_ad.inputClamp = bits.test(3) ? "4V" : "3V";
//       m_ad.powerDown = bits.test(2);
//    } else if (address == fpga::ad9826::reg::muxconfig) {
//       m_ad.muxOrder = bits.test(7) ? "RGB" : "BGR";
//       m_ad.redSelect = bits.test(6);
//       m_ad.greenSelect = bits.test(5);
//       m_ad.blueSelect = bits.test(4);
//    } else if (address == fpga::ad9826::reg::gain) {
//       m_ad.gainInteger = data;
//       m_ad.gainVolt =
//           6.0 / (1.0 + 5.0 * (63 - static_cast<double>(data)) / 63.0);
//    } else if (address == fpga::ad9826::reg::offset) {
//       m_ad.offsetInteger = data;
//       m_ad.offsetMilliVolt =
//           1.17647058823529411765 *
//           static_cast<double>(data & 0x00FF);  // Just the 8 LSBs
//       if (bits.test(8)) m_ad.offsetMilliVolt = -1.0 * m_ad.offsetMilliVolt;
//    } else if (m_verbosity == Verbosity::debug) {
//       std::cout << "Unknown AD9826 register\n";
//    }
// }

// bool Camera::getAD9826Config() {
//    //
//    const size_t nBytes = 12;
//    const unsigned char writeBuffer[nBytes] = {
//        fpga::command::rw_adconf, fpga::ad9826::cmd::read_config,     0x00,
//        fpga::command::rw_adconf, fpga::ad9826::cmd::read_mux_config, 0x00,
//        fpga::command::rw_adconf, fpga::ad9826::cmd::read_gain,       0x00,
//        fpga::command::rw_adconf, fpga::ad9826::cmd::read_offset,     0x00};
//    ft245_.write(writeBuffer, nBytes);

//    // Read back the result, same number of bytes
//    unsigned char buffer[nBytes] = {0};
//    int readBytes = ft245_.read(buffer, nBytes);

//    // Decode the recieved data
//    for (int i = 0; i < 4; ++i) {
//       auto pkt = this->decodePacket(buffer[i * 3], buffer[i * 3 + 1],
//                                     buffer[i * 3 + 2]);
//       this->decodeAD9826ConfigPacket(pkt);
//    }

//    m_ad.print();

//    return true;
// }

// bool Camera::sampleTemperatures() {
//    ft245_.writeByte(fpga::command::toggle_mcp);
//    // The FTDI latency timer is dominating the delay, so delay is not needed.

//    // Store timepoint to be used to update PID regulator
//    auto now = std::chrono::steady_clock::now();

//    // Read back the result
//    const size_t nBytes = 9;
//    unsigned char buffer[nBytes] = {0};
//    int readBytes = ft245_.read(buffer, nBytes);

//    if (m_verbosity == Verbosity::debug) {
//       std::cout << "DEBUG: Received ";
//       for (int i = 0; i < nBytes; ++i) {
//          std::cout << ' ' << std::bitset<8>(buffer[i]);
//       }
//       std::cout << '\n';
//    }

//    // Decode the recieved packets to temperature values
//    for (int i = 0; i < 3; ++i) {
//       auto pkt = this->decodePacket(buffer[i * 3], buffer[i * 3 + 1],
//                                     buffer[i * 3 + 2]);
//       if (pkt.topic == fpga::DataTopic::mcp) {
//          this->decodeTemperatures(pkt);
//       } else if (m_verbosity == Verbosity::debug) {
//          std::string topic = "unknown";
//          if (pkt.topic == fpga::DataTopic::adconf)
//             topic = "adconf";
//          else if (pkt.topic == fpga::DataTopic::pixel)
//             topic = "pixel";
//          std::cout << "DEBUG: "
//                    << " Expected topic 'mcp', got topic '" << topic << "'\n";
//       }
//    }

//    // Update PID regulator if cooling is on
//    if (m_coolerOn) {
//       double pidOut = m_pid.calculate(
//           now,
//           this->m_thermistors.at(fpga::thermistor_id::ccd).getCelsius());
//       m_pidOutPercent =
//           pidOut / (m_pid.getMaximum() - m_pid.getMinimum()) * 100.0;
//       unsigned char pwm1 = static_cast<unsigned char>(pidOut);
//       // The cold-side Peltier element should not cool as much
//       unsigned char pwm2 = static_cast<unsigned char>(pidOut * 0.8);
//       this->setPeltierPWM(1, pwm1);
//       this->setPeltierPWM(2, pwm2);
//    }

//    return readBytes == nBytes;
// }

// double Camera::getTemperature(const uint16_t thermistor) {
//    return m_thermistors.at(thermistor).getCelsius();
// }

// bool Camera::openShutter() {
//    return ft245_.writeByte(fpga::command::open_shutter) == 1;
// }

// bool Camera::closeShutter() {
//    return ft245_.writeByte(fpga::command::close_shutter) == 1;
// }

// bool Camera::setPeltierPWM(const int peltier, const unsigned char pwmVal) {
//    unsigned char writeBuffer[3];
//    writeBuffer[0] = fpga::command::set_register;

//    if (peltier == 1) {
//       writeBuffer[1] = fpga::reg_addr::tec1_duty;
//    } else if (peltier == 2) {
//       writeBuffer[1] = fpga::reg_addr::tec2_duty;
//    } else {
//       std::cerr << "Unsupported peltier '" << peltier << "'\n";
//       return false;
//    }
//    writeBuffer[2] = pwmVal;

//    // Just write: we are not expecting anything back from the FPGA.
//    return ft245_.write(writeBuffer, 3);
// }

// bool Camera::setCCDReadoutMode(const unsigned char mode) {
//    unsigned char writeBuffer[3];
//    writeBuffer[0] = fpga::command::set_register;
//    writeBuffer[1] = fpga::reg_addr::ccd_readout_mode;
//    writeBuffer[2] = mode;

//    return ft245_.write(writeBuffer, 3);
// }

// void Camera::setVerbosity(Verbosity v) {
//    m_verbosity = v;
//    m_pid.setVerbosity(v);
// }

// void Camera::setCoolerOn(const bool on) {
//    // Turn off cooling by setting the PWM outputs to 0
//    if (!on) {
//       this->setPeltierPWM(1, 0);
//       this->setPeltierPWM(2, 0);
//    }
//    m_coolerOn = on;
// }

// void Camera::setTemperature(double celsius) { m_pid.setTarget(celsius); }

// void Camera::reset() {
//    if (!ft245_.writeByte(fpga::command::reset)) {
//       throw std::runtime_error("Unable to reset camera");
//    }
// }

// std::vector<uint16_t> Camera::getActiveImageData() {
//    // Discards all invalid pixels at the sensor edges
//    std::vector<uint16_t> activeImageData;
//    for (int y = 0; y < this->getActiveHeight(); ++y) {
//       for (int x = 0; x < this->getActiveWidth(); ++x) {
//          activeImageData.push_back(
//              m_imageData[x + this->getInvalidLeft() + y * this->getWidth()]);
//       }
//    }
//    std::cout << m_imageData.size() << '\n';
//    return activeImageData;
// }
