bjornvaktaren/ccd-kaf-cdip24/software/include/Fpga.hpp

#pragma once

#include <stdint.h>

namespace fpga {

namespace command {
static constexpr unsigned char none = 0b00000000;
static constexpr unsigned char toggle_mcp = 0b00000001;
static constexpr unsigned char toggle_read_ccd = 0b00000010;
static constexpr unsigned char open_shutter = 0b00000100;
static constexpr unsigned char close_shutter = 0b00001000;
static constexpr unsigned char rw_adconf = 0b00010000;
static constexpr unsigned char set_register = 0b00100000;
static constexpr unsigned char reset = 0b11111111;
}  // namespace command

// Named addresses of the FPGA internal register
namespace reg_addr {
static constexpr unsigned char tec1_duty = 0;
static constexpr unsigned char tec2_duty = 1;
static constexpr unsigned char ccd_readout_mode = 2;
}  // namespace reg_addr

// Supported read-out modes
namespace ccd_readout_mode {
static constexpr unsigned char flush = 0b00000000;
static constexpr unsigned char bin1x1 = 0b00000001;
static constexpr unsigned char bin2x2 = 0b00000010;
}  // namespace ccd_readout_mode

// Named commands to read/write from/to the AD9826 configuration register
namespace ad9826 {
namespace cmd {
static constexpr unsigned char write_config = 0b00000000;
static constexpr unsigned char read_config = 0b10000000;
static constexpr unsigned char write_mux_config = 0b00010000;
static constexpr unsigned char read_mux_config = 0b10010000;
// Red PGA gain register. We are not using the others.
static constexpr unsigned char write_gain = 0b00100000;
static constexpr unsigned char read_gain = 0b10100000;
// Red offset register. We are not using the others.
static constexpr unsigned char write_positive_offset = 0b01010000;
static constexpr unsigned char write_negative_offset = 0b01010001;
static constexpr unsigned char read_offset = 0b11010000;
}  // namespace cmd
namespace reg {
static constexpr uint16_t data_mask = 0b0000000111111111;
static constexpr uint16_t addr_mask = 0b0111000000000000;
static constexpr uint16_t config = 0b0000000000000000;
static constexpr uint16_t muxconfig = 0b0001000000000000;
static constexpr uint16_t gain = 0b0010000000000000;
static constexpr uint16_t offset = 0b0101000000000000;
}  // namespace reg
}  // namespace ad9826

namespace data_topic {
// Each message is sent with a 8-bit header
static constexpr unsigned char pixel = 0b00000001;
static constexpr unsigned char mcp = 0b00000010;
static constexpr unsigned char adconf = 0b00000011;
}  // namespace data_topic

enum class DataTopic { unknown, mcp, adconf, pixel };
struct DataPacket {
   DataTopic topic = DataTopic::unknown;
   uint16_t data = 0;
};

namespace thermistor_id {
// Identifier for the thermistor, sent from the FPGA.
// The 2 least significant bits are not used.
static constexpr uint16_t ccd = 0b1000000000000000;
static constexpr uint16_t tec = 0b1001000000000000;
static constexpr uint16_t ambient = 0b1010000000000000;
static constexpr uint16_t bitmask = 0b1111110000000000;
}  // namespace thermistor_id
}  // namespace fpga
