bjornvaktaren/ccd-kaf-cdip24/software/include/Camera.hpp

#ifndef CAMERA_HPP
#define CAMERA_HPP

#include <stdint.h>

#include <bitset>
#include <chrono>
#include <cmath>
#include <iostream>
#include <map>
#include <stdexcept>
#include <thread>
#include <vector>

#include "AD9826.hpp"
#include "Fpga.hpp"
#include "Ft245_if.hpp"
#include "PID.hpp"
#include "Thermistor.hpp"
#include "Verbosity.hpp"

class Camera {
  public:
   Camera(Ft245Interface& ft245);
   ~Camera(){};

   void connect();
   // void disconnect();
  
   // void setVerbosity(Verbosity v);

   // bool setGain(const unsigned char gain);
   // bool setOffset(const unsigned char offset, const bool negative = false);
   // bool getAD9826Config();
   // bool setCCDReadoutMode(const unsigned char mode);
  
   // std::vector<uint16_t> getImageData() const { return m_imageData; };
   // std::vector<uint16_t> getActiveImageData();
   // void startExposure(const bool openShutter = true);
   // void stopExposure(const bool closeShutter = true);
   // void flushSensor();
   // bool openShutter();
   // bool closeShutter();

   // bool sampleTemperatures();
   // double getTemperature(const uint16_t thermistor);
   // bool getCoolerOn() const { return m_coolerOn; };
   // void setCoolerOn(const bool on = true);
   // double getCoolerOutputPercent() const { return m_pidOutPercent; };
   // double getTargetTemperature() const { return m_pid.getTarget(); };
   // void setTemperature(double celsius);


   // Image size in number of pixels
   constexpr int getWidth() const { return 2267; };
   constexpr int getHeight() const { return 1510 + 1; };
   constexpr int getActiveWidth() const { return 2184; };
   constexpr int getActiveHeight() const { return 1472; };
   constexpr int getInvalidLeft() const { return 50; };
   constexpr int getInvalidRight() const { return 33; };
   constexpr int getInvalidTop() const { return 35; };
   constexpr int getInvalidBottom() const { return 4; };

   // // Pixel size in micrometer
   // double getPixelWidth() const { return 6.8; };
   // double getPixelHeight() const { return 6.8; };

   // // ADC channels
   // int getADCResolution() const { return 16; };

   // void reset();

   // void test();

  private:
   fpga::DataPacket decodePacket(const unsigned char byte1,
                                 const unsigned char byte2,
                                 const unsigned char byte3);
   void decodeTemperatures(const fpga::DataPacket packet);
   void decodeAD9826ConfigPacket(const fpga::DataPacket packet);

   bool setPeltierPWM(const int peltier, const unsigned char pwmVal);

   Verbosity m_verbosity;
   bool m_coolerOn;
   Ft245Interface& ft245_;
   AD9826 m_ad;
   std::map<uint16_t, Thermistor> m_thermistors;
   double m_ccdTargetTemperature;
   PID m_pid;
   double m_pidOutPercent;
   std::vector<uint16_t> m_imageData;
   std::vector<unsigned char> m_rawPixelData;
};

#endif
