bjornvaktaren/ccd-kaf-cdip24/(commit log)

2020-03-17 added simulation of bias tee and stuff
    [ccd.sch, ccd_voltage.sch, fpga.sch, kaf_board.sch, usb-interface.sch]
2020-03-22 added custum libraries and latest changes
    [ccd.sch, fpga.sch, kaf_board.sch]
2020-03-22 started adding thermistors and peltier control
    [ccd.sch, ccd_voltage.sch, fpga.sch, kaf_board.sch, power.sch, thermo_and_mechanical.sch, usb-interface.sch]
2020-03-26 Added PWM signals
    [ccd.sch, fpga.sch, kaf_board.sch, thermo_and_mechanical.sch, usb-interface.sch]
2020-03-26 minor changes
    [ccd.sch, ccd_voltage.sch, fpga.sch, power.sch, thermo_and_mechanical.sch, usb-interface.sch]
2020-04-09 added two power supplies
    [ccd.sch, power.sch]
2020-04-09 added a power supply
    [power.sch]
2020-04-12 updates to schematics
    [ccd.sch, ccd_voltage.sch, kaf_board.sch, power.sch, thermo_and_mechanical.sch]
2020-04-12 starting on the software: currently getting and plotting temperature
    [power_requirements.ods]
2020-04-24 FT245 interface seems to be working, but missing 2 bits from the MCP
    [breadboard_tests.v, ice40hx1k-evb.pcf, mcp3008_interface.v]
2020-04-25 Fixed the MCP error
    [Camera.cpp, Fpga.hpp, Thermistor.cpp, Thermistor.hpp, mcp3008_interface.v]
2020-04-27 The MCP now reads two thermistor values
2020-05-02 updated schematics. Mainly supplies
    [ccd_voltage.sch, power.sch, power_requirements.ods, thermo_and_mechanical.sch, usb-interface.sch]
2020-05-03 switched to single-ended temperature measurement
2020-05-03 Servo controller for the camera shutter implemented in FPGA
2020-05-05 Fixed servo pwm delay between pulses
    [breadboard_tests.v]
2020-05-06 Can now set PWM value, but somehow it broke the temperature query...
    [Camera.cpp, Camera.hpp, Fpga.hpp, Ft245.cpp, Ft245.hpp, breadboard_tests.v, ice40hx1k-evb.pcf, main.cpp]
2020-05-08 Setting the PWM value works, but the subsequent temperature query return jibberish 1/10 of the time after. If the PWM is not set, everything else works as expected.
2020-05-12 started associating footprints
    [ccd.sch, ccd_voltage.sch, fpga.sch, power.sch, thermo_and_mechanical.sch, usb-interface.sch]
2020-05-17 associating footprints
    [ccd.sch, ccd_voltage.sch, fpga.sch, power.sch, thermo_and_mechanical.sch, usb-interface.sch]
2020-05-22 finished assigning footprints
    [ccd.sch, fpga.sch, kaf_board.kicad_pcb, power.sch, thermo_and_mechanical.sch, usb-interface.sch]
2020-05-26 continued placing footprints
    [ccd.sch, kaf_board.kicad_pcb]
2020-05-29 added board outline
    [ccd_voltage.sch, kaf_board.kicad_pcb, power.sch, thermo_and_mechanical.sch]
2020-05-31 continued footprint placement
    [ccd.sch, kaf_board.kicad_pcb, thermo_and_mechanical.sch]
2020-06-05 changes schematics and PCB to ice40hx1k-vq100
    [fpga.sch, kaf_board.kicad_pcb]
2020-06-07 added oscillator to fpga. footprint placement
    [fpga.sch, kaf_board.kicad_pcb]
2020-06-09 changed all board i/o to go through a pin header and placed power components
    [ccd.sch, ccd_voltage.sch, fpga.sch, kaf_board.kicad_pcb, kaf_board.sch, power.sch, thermo_and_mechanical.sch, usb-interface.sch]
2020-06-11 have made a preliminary placement of components
    [fpga.sch, kaf_board.kicad_pcb, thermo_and_mechanical.sch]
2020-06-12 changed some connectors and moved components
    [ccd.sch, fpga.sch, kaf_board.kicad_pcb, kaf_board.sch, power.sch, power_requirements.ods, thermo_and_mechanical.sch, usb-interface.sch]
2020-06-14 Started routing PCB
    [fpga.sch, kaf_board.kicad_pcb, thermo_and_mechanical.sch, usb-interface.sch]
2020-06-14 continued routing
    [kaf_board.kicad_pcb]
2020-06-26 Changed +-15 DC/DC converter and routed it.
    [ccd.sch, ccd_voltage.sch, fpga.sch, kaf_board.kicad_pcb, power.sch, power_requirements.ods, thermo_and_mechanical.sch, usb-interface.sch]
2020-06-28 Power plane design and started routing the CCD circuit supplies
    [ccd.sch, ccd_voltage.sch, kaf_board.kicad_pcb]
2020-06-28 Most things connected on PCB except GND. Doing ERC.
    [kaf_board.kicad_pcb]
2020-07-01 PCB design finished. Will go over the traces once more.
    [ccd_voltage.sch, kaf_board.kicad_pcb, usb-interface.sch]
2020-07-01 Minor changes to PCB
    [ccd.sch, ccd_voltage.sch, kaf_board.kicad_pcb, power.sch]
2020-07-03 Decided to ditch the TL432 in favour of a +-14.5V LDO regulator. Need to re-route a lot of stuff
    [ccd.sch, ccd_voltage.sch, fpga.sch, kaf_board.kicad_pcb, power.sch, usb-interface.sch]
2020-07-05 Replaced the MAX743 +-15V converted with another. Not yet routed.
    [ccd_voltage.sch, kaf_board.kicad_pcb, power.sch]
2020-07-05 Routed the +-15V converter
    [kaf_board.kicad_pcb]
2020-07-05 Placed +-15V converter
    [kaf_board.kicad_pcb]
2020-07-16 Last changes before sending PCB to manufacturing
    [fpga.sch, kaf_board.kicad_pcb, power.sch]
2020-08-28 Started testing the PCBA. Changed FTDI connection string from UM232H to FT2232H. Added EEPROM config file for FT2232H.
    [kaf_board.kicad_pcb, power.sch]
2020-09-04 Marked R59 as NA, i.e. it should not be populated.
    [ccd.sch, fpga.sch, usb-interface.sch]
2020-09-05 The FT245 interface of the FPGA works, but if I enable the ccd_toggle state it gets stuck waiting for the ccd even though the ccd toggle command is not sent.
    [Fpga.hpp, Ft245.cpp, ice40hx1k-evb.pcf, main.cpp, top.v, top_tb.v]
2020-09-05 Reading two temperature sensors works
2020-09-08 Started on a test bench for ad9826_config. It does not work yet
    [ad9826_config.v, ad9826_config_tb.v, top_tb.v]
2020-09-11 Corrected some bugs in ad9826_config module
    [ad9826_config.v, ad9826_config_tb.v]
2020-09-18 ccd_readout module works in simulation. Something wrong with reading from FPGA. Software or firmware issue?
    [Camera.cpp, Fpga.hpp, Ft245.cpp, ccd_readout.v, main.cpp, top.v, top_tb.v]
2020-10-04 Untested software update: decode temperature reading.
2020-10-04 Makefile updates and started adding indigo driver
2020-10-08 Continued with indigo driver
2020-10-08 Fixed conversion of ADC values to temperature in software.
    [Camera.cpp, Fpga.hpp, main.cpp]
2020-10-09 Got reading AD9826 configuration register to work in firmware
    [ad9826_config_state_filter.txt]
2020-10-12 Continued implementing indigo driver
2020-10-16 Corrected two resistors I had flipped on silk screen. Corrected to cap values
    [ccd_voltage.sch, kaf_board.kicad_pcb, power.sch]
2020-10-16 Created a PID regulator in software
2020-10-16 Some improvements to PID class
2020-10-18 Added PID regulator to Camera class.
2020-10-22 Updates to schematics after testing the PCA
    [ccd.sch]
2020-10-25 Added software to read out image from sensor
2020-10-25 Removed capacitor that made the DC/DC booster/inverter output -21V
    [ccd.sch, kaf_board.kicad_pcb, power.sch]
2020-10-29 Fixes to software and firmware
    [Fpga.hpp, ccd_readout.v, main.cpp, top.v, top_tb.v]
2020-11-08 Think I got CCD readout to work! Will attach CCD chip
2020-11-18 Reading out CCD works
    [kaf_board.kicad_pcb]
2020-11-18 Added CAD drawing of optical window
    [optical_window.scad]
2020-12-25 Fixed flipped gate and source on mosfets
    [kaf_board.kicad_pcb]
2020-12-25 Software and firmware updates
    [optical_window.scad]
2021-01-12 Readout is still missing a few pixels in each frame
    [Camera.cpp, Camera.hpp, Ft245.cpp, ccd_readout.v, main.cpp, top.v]
2021-01-17 Fixed sensor readout
2021-01-31 Changed tx_fifo depth. Calibrated shutter.
2021-02-03 Added option to take dark frame
2021-02-09 Fixed small stupid error
    [main.cpp]
2021-02-10 Corrected PID class and added more functionallity to main
    [Camera.cpp, Camera.hpp, PID.cpp, PID.hpp, main.cpp]
2021-02-21 Trimmed PID and formatted some debug messages
2024-03-01 Started rewriting for testability. Broke out camera configuration in its own class
    [AD9826.hpp, Camera.hpp, CameraConfiguration.cpp, CameraConfiguration.hpp, Fpga.hpp, Ft245_if.hpp]
2024-12-15 More unit tests for CameraConfiguration
